CannaCardo/Urukul/(list of files, drawings)

Other design files:
PCB/Urukul.PcbDoc
SCH/CLK_INPUT.SchDoc
SCH/CPCIS_Connectors_P1_P6.SchDoc
SCH/DDS_OUT_channel.SchDoc
SCH/FPGA.SchDoc
SCH/FPGA_Bank0-2.SchDoc
SCH/FPGA_Bank3.SchDoc
SCH/FPGA_Config.SchDoc
SCH/FPGA_Supply.SchDoc
SCH/I2C_switch.SchDoc
SCH/LEDs.SchDoc
SCH/Power-up_delay.SchDoc
SCH/Power_main_DCDC.SchDoc
SCH/Power_Supplies.SchDoc
SCH/Urukul.SchDoc
Urukul.PrjPCB
