CannaCardo/Urukul/(commit log)

2026-09-23 Schematic review corrections
    Updated project options
    Synchronized ports on schematic pages
    Component designators changed:
    C16->C225, C82->C4, C85->C214, C111->C3, C114->C213, L1->L11, L15->L12, R20->R35, R51->R33
    PGOOD renamed to PGOOD_AFE to beter reflect behaviour
    I2C switches rewired from PGOOD (now PGOOD_AFE) to PGOOD_FPGA
    Schematic pages renamed:
    Urukul_FPGA_Config.SchDoc -> FPGA_Config.SchDoc
    Urukul_FPGA.SchDoc -> FPGA_Bank0-2.SchDoc
    Urukul_FPGA_LVDS -> FPGA_Bank3.SchDoc
    Urukul_FPGA_Supply.SchDoc -> FPGA_Supply.SchDoc
    MGT signals removed using a compile mask
    FPGA_Supply - rearanged capacitors, added 3 100nF and 2 10uF to teh VCCIO0-2 P3V3 rail. 10uF left in space of specified 4u7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
    [CPCIS_Connectors_P1_P6.SchDoc, FPGA.SchDoc, FPGA_Bank0-2.SchDoc, FPGA_Bank3.SchDoc, FPGA_Config.SchDoc, FPGA_Supply.SchDoc, I2C_switch.SchDoc, LEDs.SchDoc]
2026-09-29 PCB review corrections
    Followed schematics changes from previous commit, additionally:
    Added rule to increase connection width for thermal pad on IC2/IC13
    Corrected UnRoutedNet rule
    Vias tented enabled in rules
    Removed obsolete rules
    Reviewed 50R/ D100 controlled impedance traces - selectively corrected dimensions of most outliers.
    Modified case 3D model clearance rule to be more strict
    Fixed power polygon on NetC123_2
    Widened necks on power polygons under FPGA
    Added TP23 silkscreen
    Unified connector silkscreen text dimensions
    T_SW1 designator on silkscreen moved within board outline
    Impedance table removed from mechanical layer
    Added details on keepout mesh used in copper balancing generat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
2026-10-15 Synchronized with DIOT_Template v1.4
    -updated project parameters
    -updated schematic sheet templates
    -updated Temperature_monitoring.SchDoc IC
    -updated 100nF 0402 passives to match template
    -updated 10nF 0402 passives to match template
    -C3, C213, C223, C228 changed from CC0603_1UF_25V_10%_X7R to CC0402_1UF_16V_10%_X5R
    -C4, C258 changed from CC0805_10UF_16V_10%_X5R to CC0805_10UF_25V_10%_X5R
    -updated FPGA decoupling to match template
    -FPGA_Supply.SchDoc changed from A3 to A4
    -modified sheet order in the project
    -updated Draftsman file
2026-10-27 Modified stackup, impedance profiles confirmed in rules. Differential pairs rerouted. Improved power planes under FPGA
2026-10-29 v2.0rc1 - R108 and R110 changed from 10k to 4k7 to improve resistor divider with IC19 internal 25k pull-up. Low state is now below VIL max - Capacitors 22uF changed to 20V rating instead of 10V. - HW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
